Proto-Plastik/CLUB/README.md

# Printers-CLUB
Repository for the Proto-Plastik CLUB printer model
