Proto-Plastik/CLUB/A5 Bearing Assy Y-Axis/STEP/bearing cover and tray.STEP

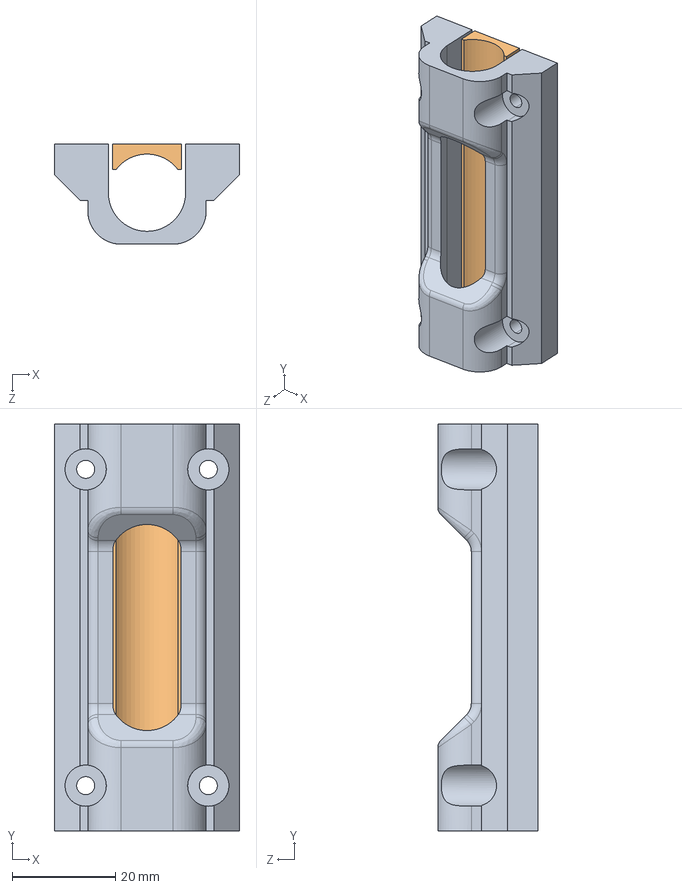
[picture p1: CAD file, 2019-01-01]
A5 Bearing Assy Y-Axis/STEP/bearing cover and tray.STEP
36.0 x 79.0 x 19.5 mm
