Proto-Plastik/CLUB/A5 Bed Chassis/STEP/bed chassis-belt retainer.STEP

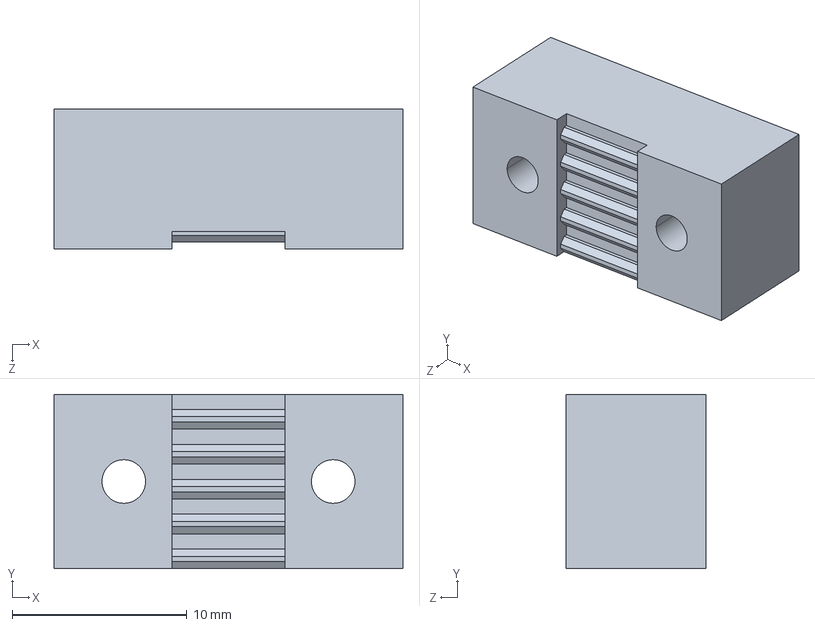
[picture p3: CAD file, 2019-01-01]
A5 Bed Chassis/STEP/bed chassis-belt retainer.STEP
20.0 x 10.0 x 8.00 mm
