Proto-Plastik/CLUB/A5 Frame Drive Housing 1Z Y-Axis/STEP/1Z y-axis-drive housing-cover.STEP

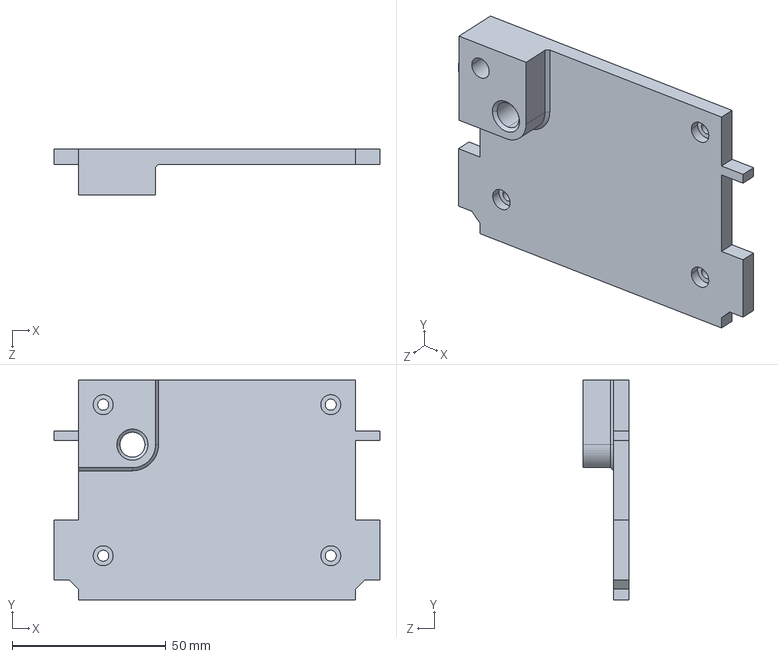
[picture p6: CAD file, 2019-01-01]
A5 Frame Drive Housing 1Z Y-Axis/STEP/1Z y-axis-drive housing-cover.STEP
106.0 x 71.5 x 15.0 mm
