Proto-Plastik/CLUB/A5 Frame Drive Housing 1Z Z-Axis/STEP/1Z z-axis-drive housing-cover.STEP

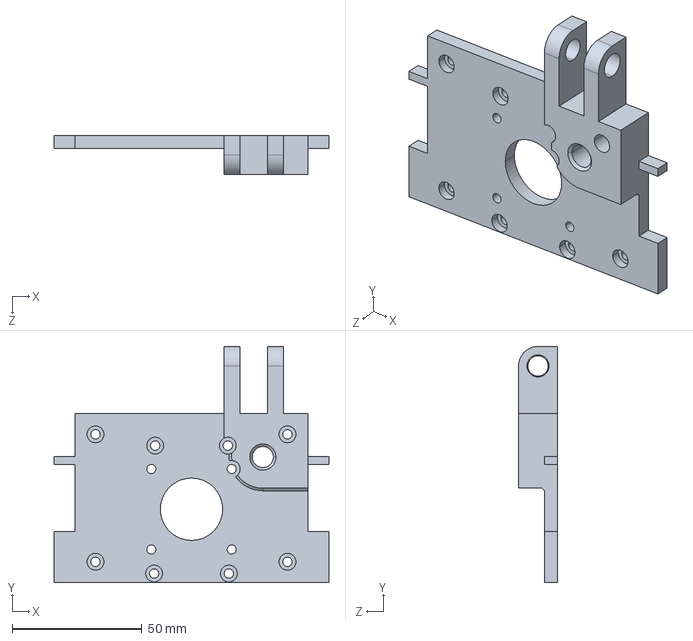
[picture p7: CAD file, 2019-01-01]
A5 Frame Drive Housing 1Z Z-Axis/STEP/1Z z-axis-drive housing-cover.STEP
106.0 x 91.0 x 15.0 mm
