Proto-Plastik/CLUB/A51Z Truss/STEP/truss handle bottom (ULTIMATE).STEP

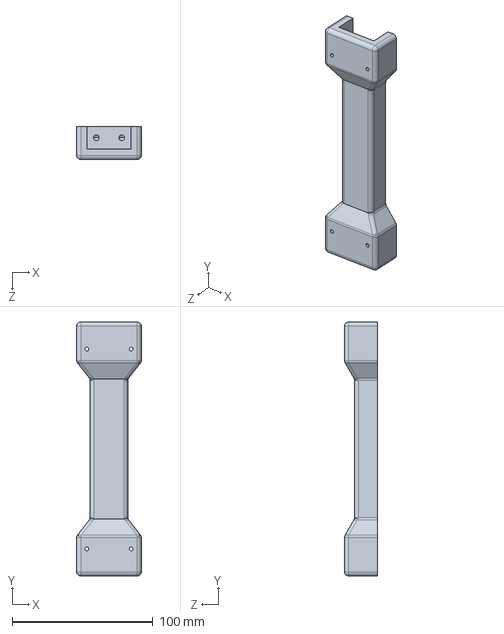
[picture p8: CAD file, 2019-01-01]
A51Z Truss/STEP/truss handle bottom (ULTIMATE).STEP
46.0 x 180.5 x 23.5 mm
