Proto-Plastik/CLUB/A51Z X-Axis Gantry-left/STEP/A51Z X-Gantry Left (300mm).STEP

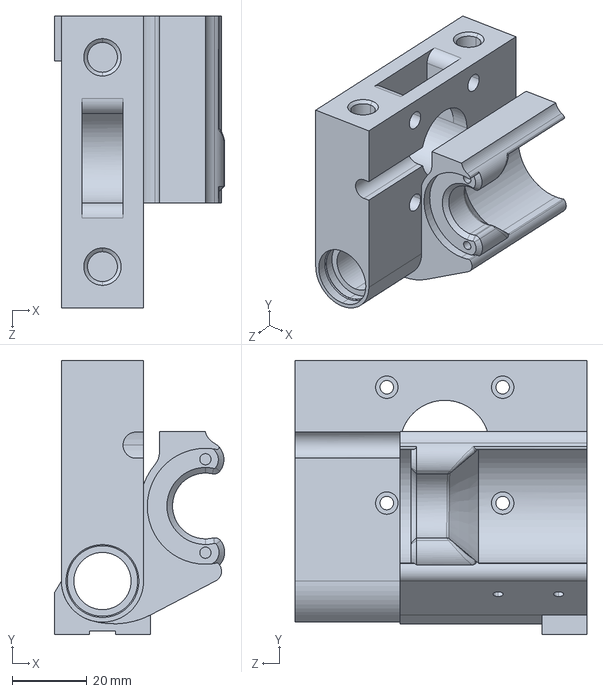
[picture p9: CAD file, 2019-01-01]
A51Z X-Axis Gantry-left/STEP/A51Z X-Gantry Left (300mm).STEP
45.6 x 73.3 x 78.0 mm
