Proto-Plastik/CLUB/A51Z X-Axis Gantry-right/STEP/A51Z X-Gantry Right (300mm).STEP

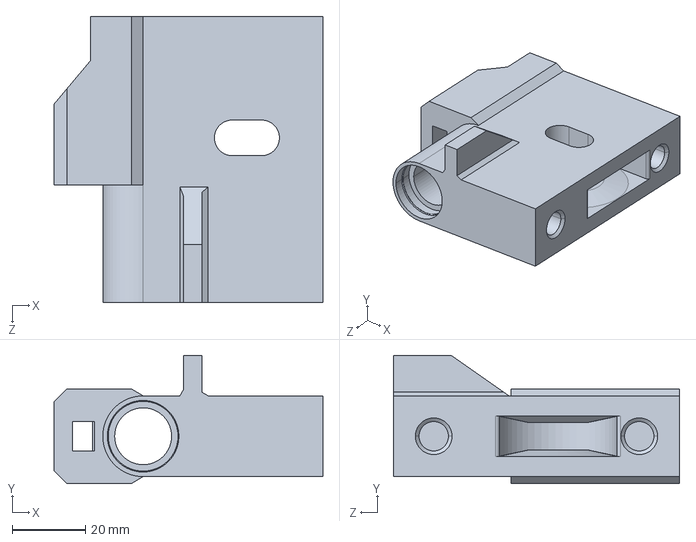
[picture p10: CAD file, 2019-01-01]
A51Z X-Axis Gantry-right/STEP/A51Z X-Gantry Right (300mm).STEP
73.3 x 34.9 x 78.0 mm
