Proto-Plastik/CLUB/Filament Drive Bearing Holder/STEP/bearing upper retainer (CLUB).STEP

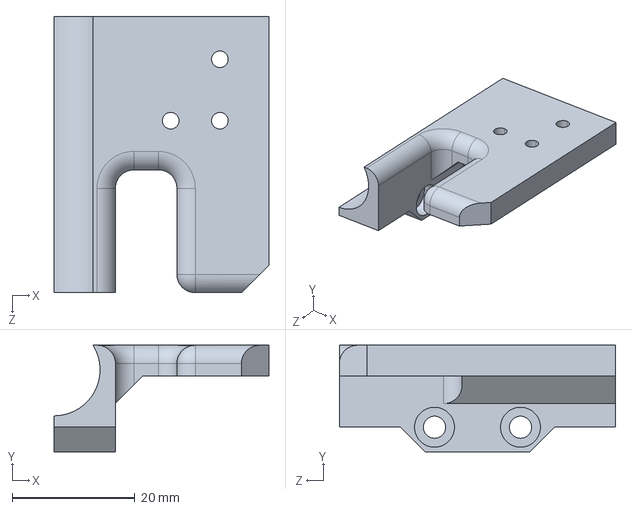
[picture p11: CAD file, 2019-01-01]
Filament Drive Bearing Holder/STEP/bearing upper retainer (CLUB).STEP
35.0 x 17.4 x 45.0 mm
