Proto-Plastik/CLUB/Filament Drive Bed Leveling/STEP/Filament Drive BL Touch Mount.STEP

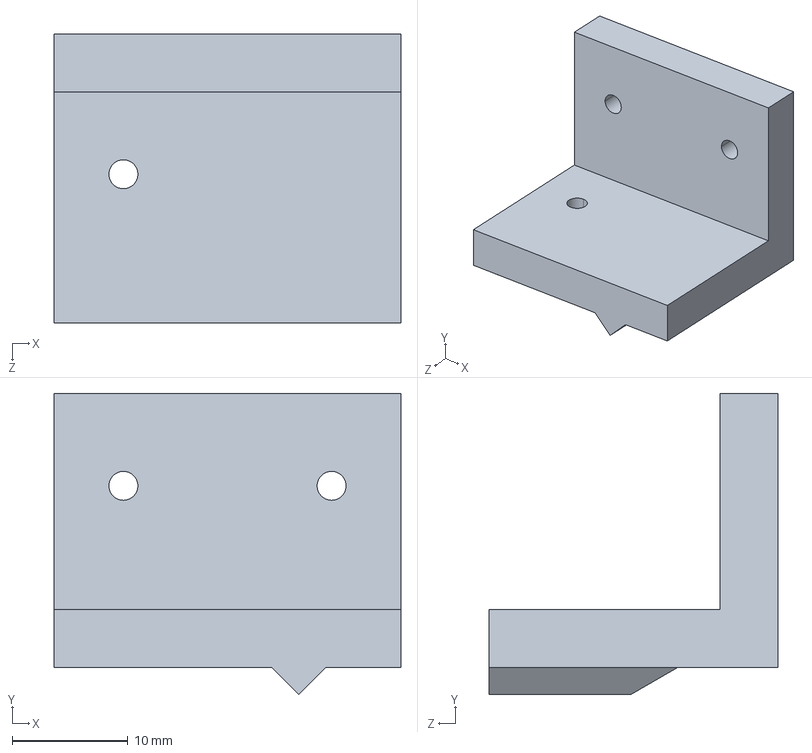
[picture p12: CAD file, 2018-01-10]
Filament Drive Bed Leveling/STEP/Filament Drive BL Touch Mount.STEP
30.0 x 26.1 x 25.0 mm
