Proto-Plastik/CLUB/Filament Drive Cooling Fan/STEP/fan nozzle.STEP

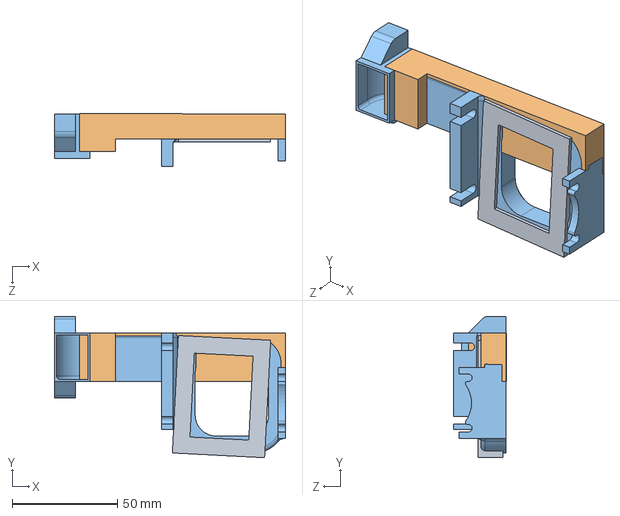
[picture p13: CAD file, 2018-01-10]
Filament Drive Cooling Fan/STEP/fan nozzle.STEP
110.0 x 67.3 x 25.1 mm
