Proto-Plastik/CLUB/Filament Drive Housing/hot end retainer.STL

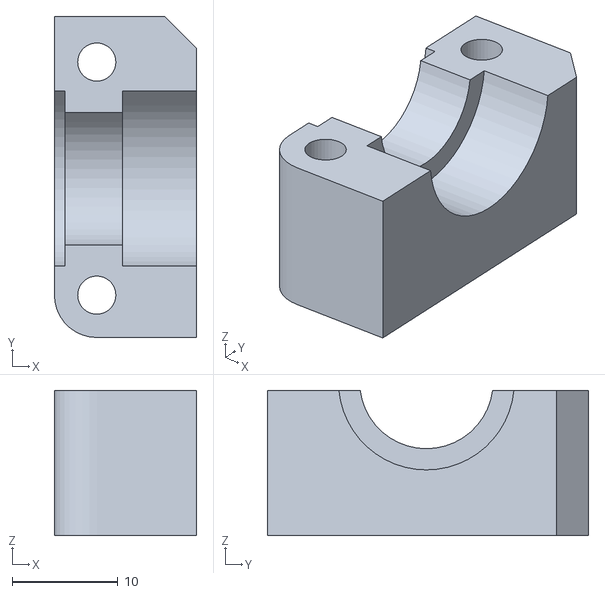
[picture p14: CAD file, 2018-01-06]
Filament Drive Housing/hot end retainer.STL
13.4 x 30.3 x 13.7
