Proto-Plastik/CLUB/Filament Drive/STEP/stepper (hardware)-dampener.STEP

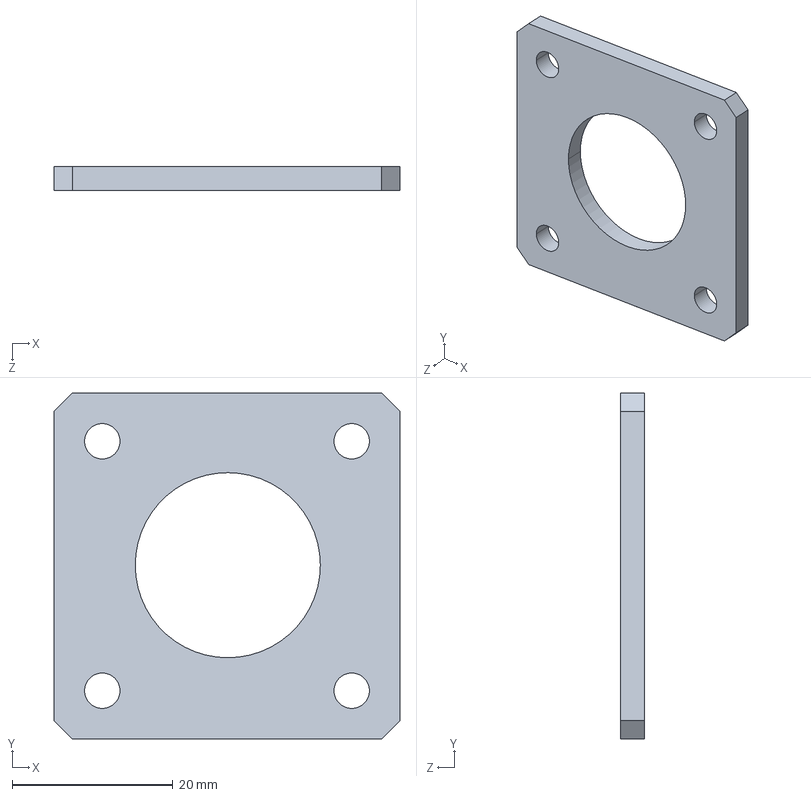
[picture p16: CAD file, 2019-01-01]
Filament Drive/STEP/stepper (hardware)-dampener.STEP
43.0 x 43.0 x 3.00 mm
