Proto-Plastik/CLUB/y-axis tightener/STEP/y-axis tightener-knob.STEP

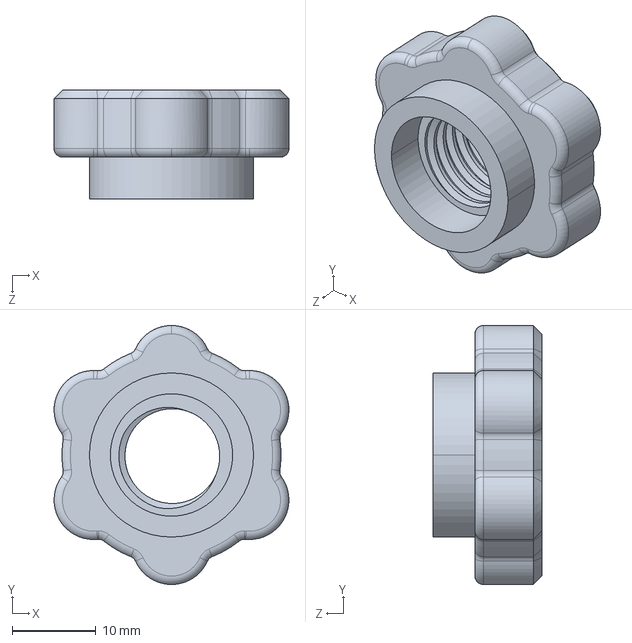
[picture p17: CAD file, 2019-01-01]
y-axis tightener/STEP/y-axis tightener-knob.STEP
28.1 x 31.0 x 13.0 mm
