Proto-Plastik/CLUB/y-axis tightener/y-axis tightener-upper clamp.STL

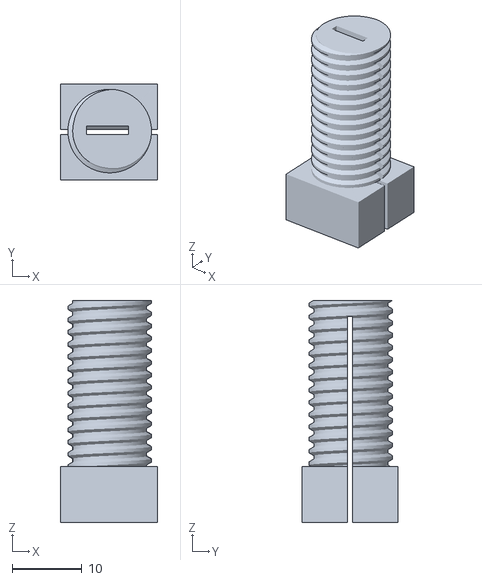
[picture p18: CAD file, 2019-01-01]
y-axis tightener/y-axis tightener-upper clamp.STL
13.9 x 13.7 x 31.8
