Proto-Plastik/CLUB/A5 Frame Chassis Center/STEP/chassis (300mm).STEP

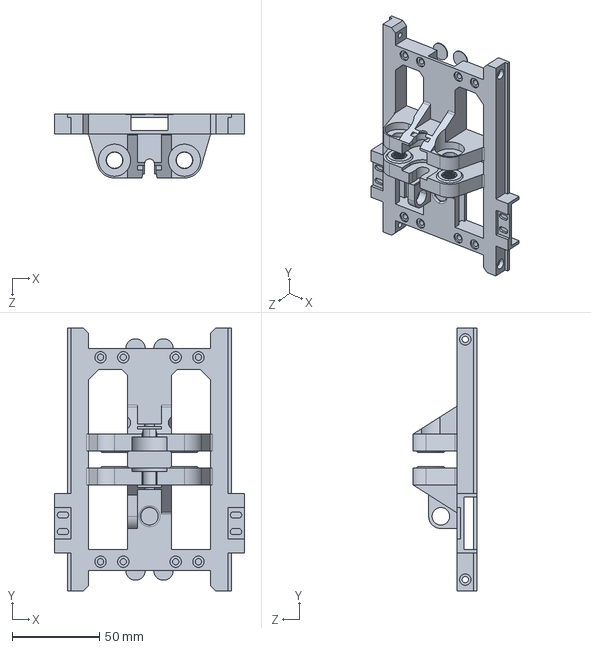
[picture p21: CAD file, 2019-01-01]
A5 Frame Chassis Center/STEP/chassis (300mm).STEP
109.0 x 150.5 x 36.7 mm
