Proto-Plastik/CLUB/A5 Frame Drive Housing 1Z Y-Axis/STEP/mounting foot TPE.STEP

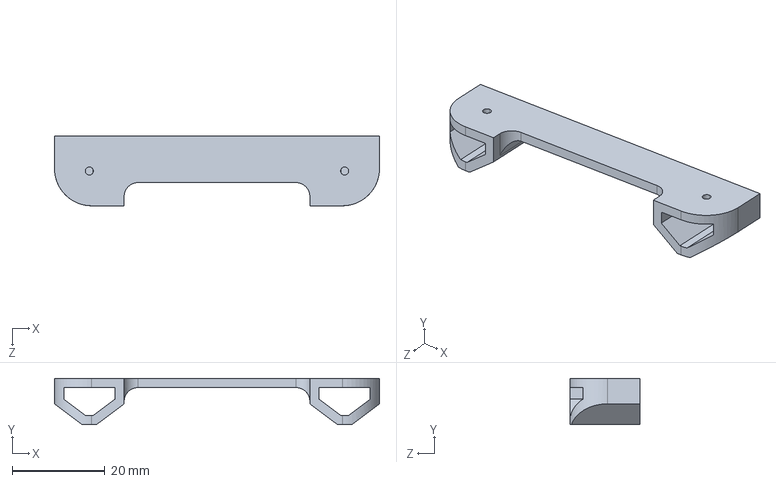
[picture p22: CAD file, 2019-01-01]
A5 Frame Drive Housing 1Z Y-Axis/STEP/mounting foot TPE.STEP
70.0 x 10.0 x 15.0 mm
