Proto-Plastik/CLUB/A5 Frame Drive Housing 1Z Z-Axis/STEP/rigid coupler.STEP

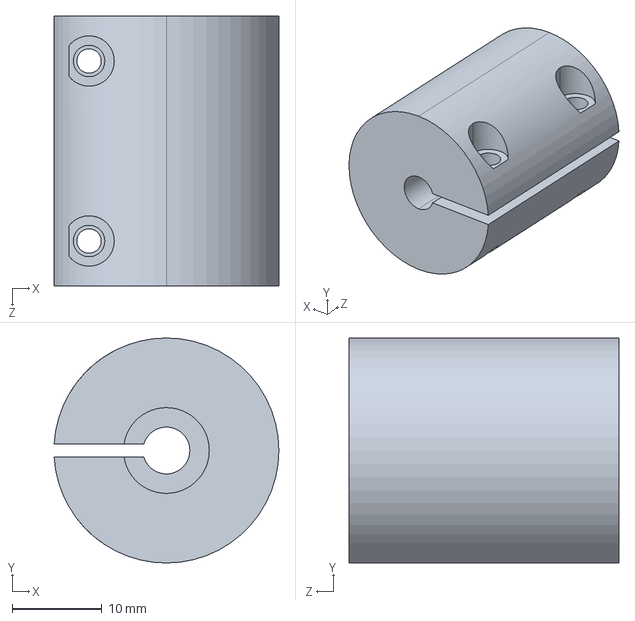
[picture p23: CAD file, 2019-01-01]
A5 Frame Drive Housing 1Z Z-Axis/STEP/rigid coupler.STEP
25.0 x 25.0 x 30.0 mm
