Proto-Plastik/CLUB/A51Z Truss/STEP/GT2_Pulley (printed pulley).STEP

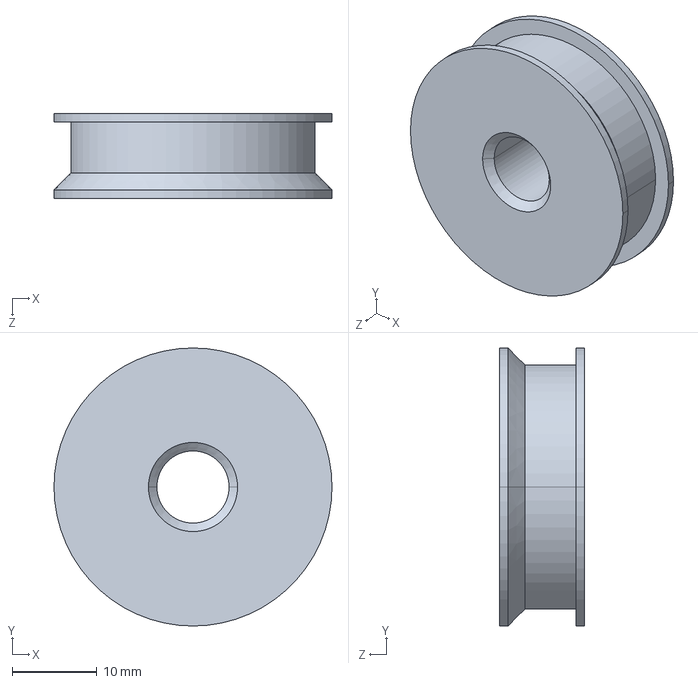
[picture p24: CAD file, 2019-01-01]
A51Z Truss/STEP/GT2_Pulley (printed pulley).STEP
32.7 x 32.7 x 10.0 mm
