Proto-Plastik/CLUB/A51Z X-Axis Gantry-left/STEP/A51Z X-Gantry-snap plug.STEP

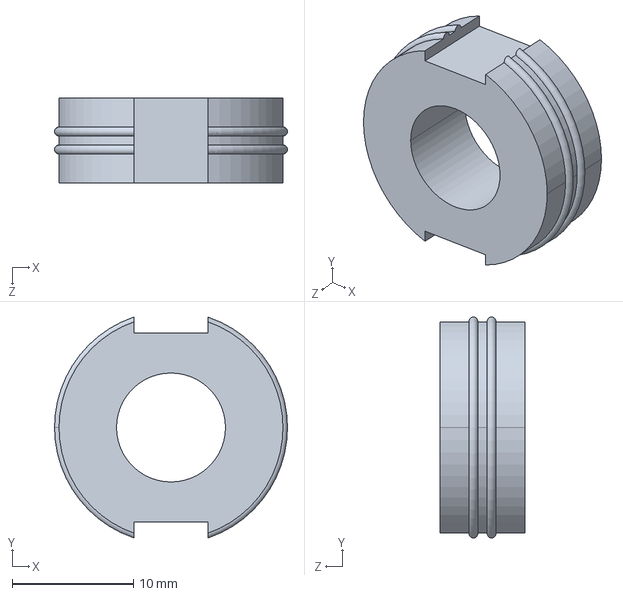
[picture p25: CAD file, 2019-01-01]
A51Z X-Axis Gantry-left/STEP/A51Z X-Gantry-snap plug.STEP
19.2 x 18.3 x 7.00 mm
