Proto-Plastik/CLUB/A51Z X-Axis Gantry-right/STEP/A51Z X-Gantry Right-tensioner.STEP

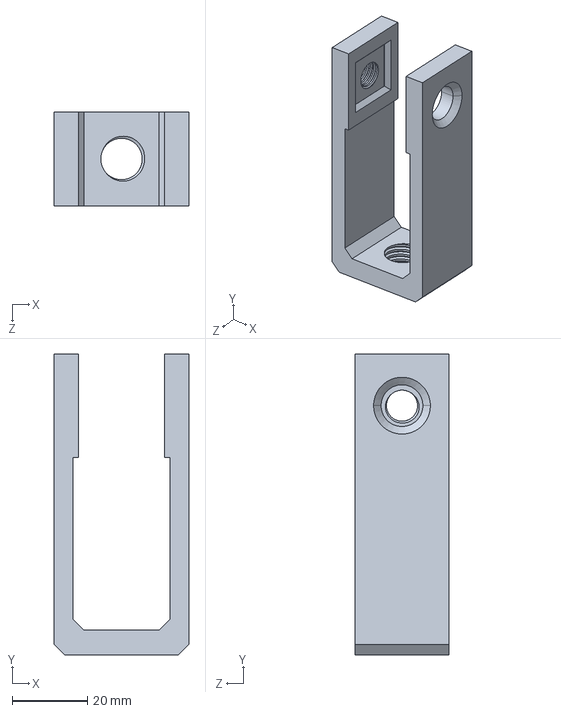
[picture p26: CAD file, 2019-01-01]
A51Z X-Axis Gantry-right/STEP/A51Z X-Gantry Right-tensioner.STEP
35.8 x 80.0 x 25.0 mm
