Proto-Plastik/CLUB/Filament Drive Bearing Holder/STEP/bearing lower retainer (CLUB).STEP

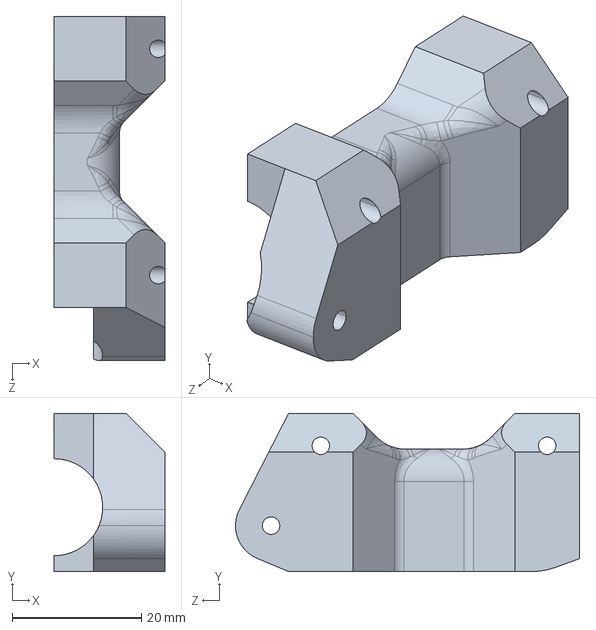
[picture p27: CAD file, 2019-01-01]
Filament Drive Bearing Holder/STEP/bearing lower retainer (CLUB).STEP
17.1 x 24.4 x 53.2 mm
