Proto-Plastik/CLUB/Filament Drive Cooling Fan/STEP/nozzle bracket.STEP

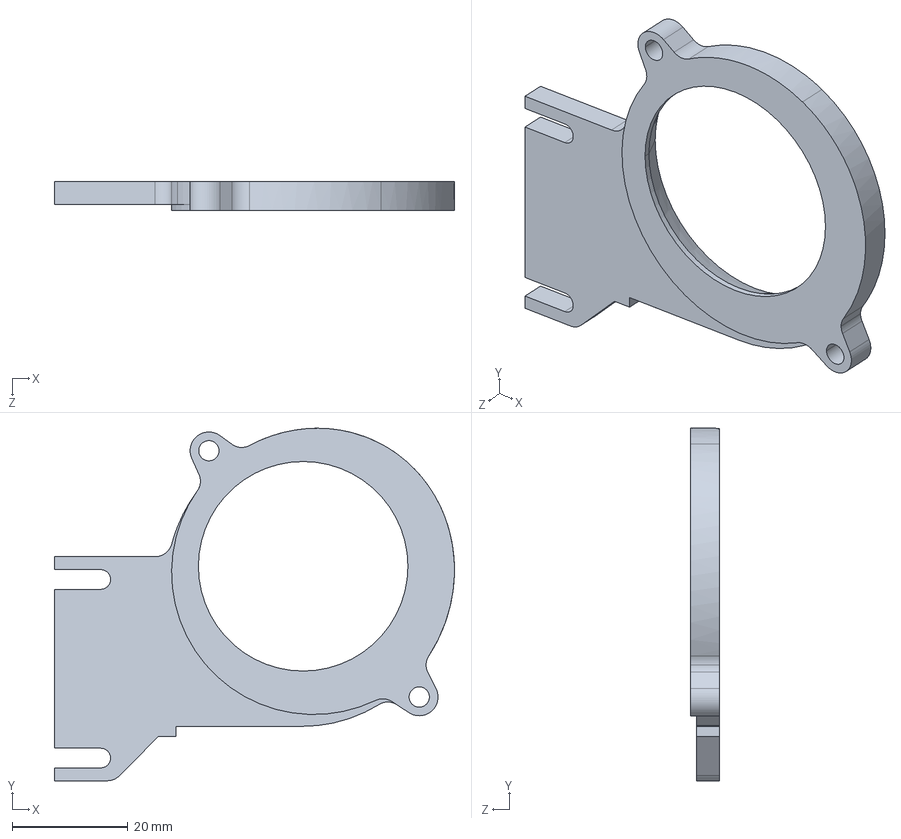
[picture p28: CAD file, 2018-01-10]
Filament Drive Cooling Fan/STEP/nozzle bracket.STEP
69.2 x 61.0 x 5.00 mm
