Proto-Plastik/CLUB/Filament Drive Housing/motor mount.STL

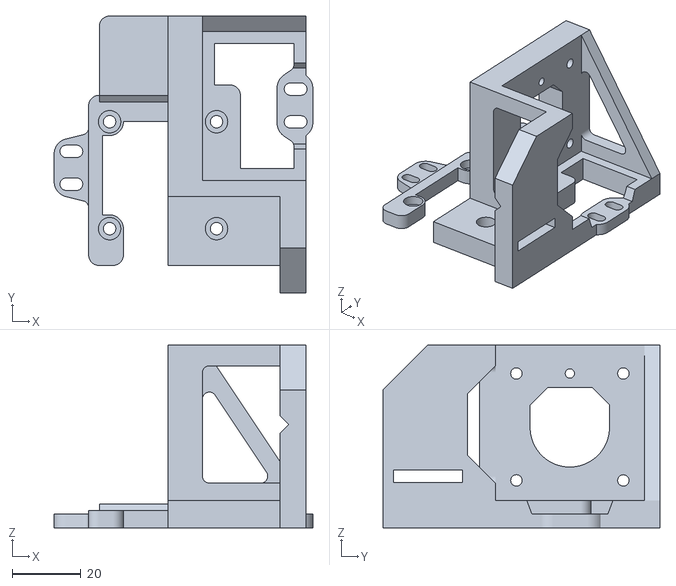
[picture p29: CAD file, 2017-12-31]
Filament Drive Housing/motor mount.STL
75.0 x 80.3 x 53.0
