Proto-Plastik/CLUB/A5 Bed Chassis/STEP/bed chassis-spreader-OH.STEP

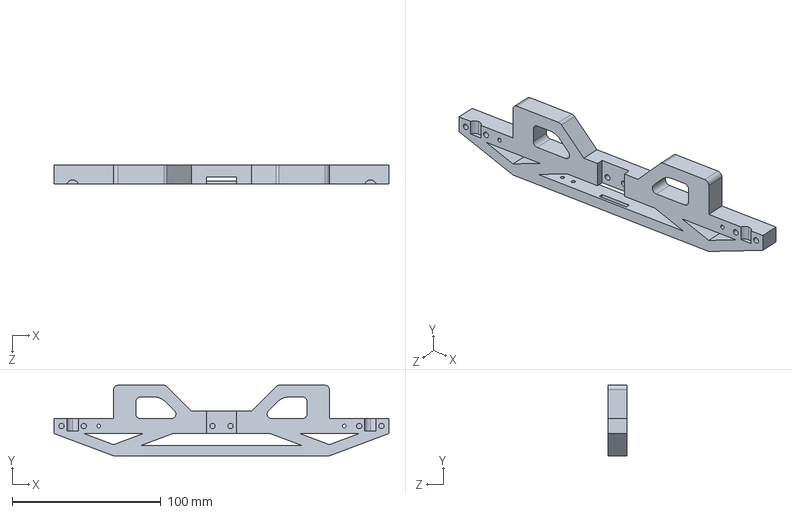
[picture p31: CAD file, 2019-01-01]
A5 Bed Chassis/STEP/bed chassis-spreader-OH.STEP
225.0 x 47.4 x 12.5 mm
