Proto-Plastik/CLUB/A5 Frame Drive Housing 1Z Y-Axis/STEP/1Z y-axis-drive housing-body.STEP

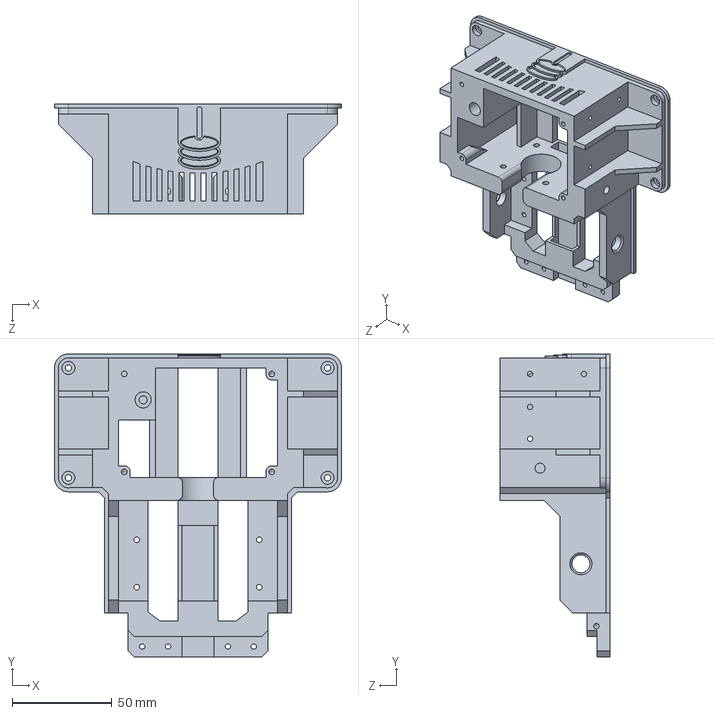
[picture p32: CAD file, 2019-01-01]
A5 Frame Drive Housing 1Z Y-Axis/STEP/1Z y-axis-drive housing-body.STEP
144.0 x 152.0 x 55.0 mm
