Proto-Plastik/CLUB/A5 Frame Drive Housing 1Z Z-Axis/STEP/RAMPS Mount-front.STEP

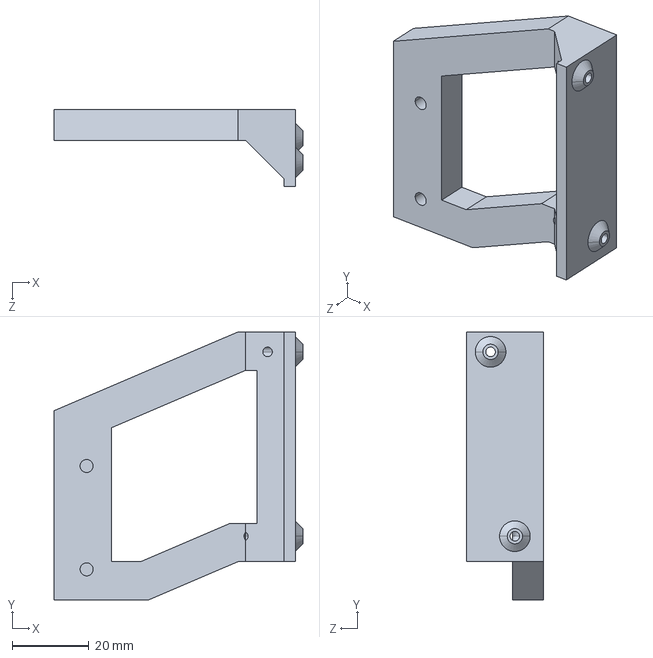
[picture p33: CAD file, 2019-01-01]
A5 Frame Drive Housing 1Z Z-Axis/STEP/RAMPS Mount-front.STEP
65.0 x 70.0 x 20.0 mm
