Proto-Plastik/CLUB/A51Z Truss/STEP/truss right .STEP

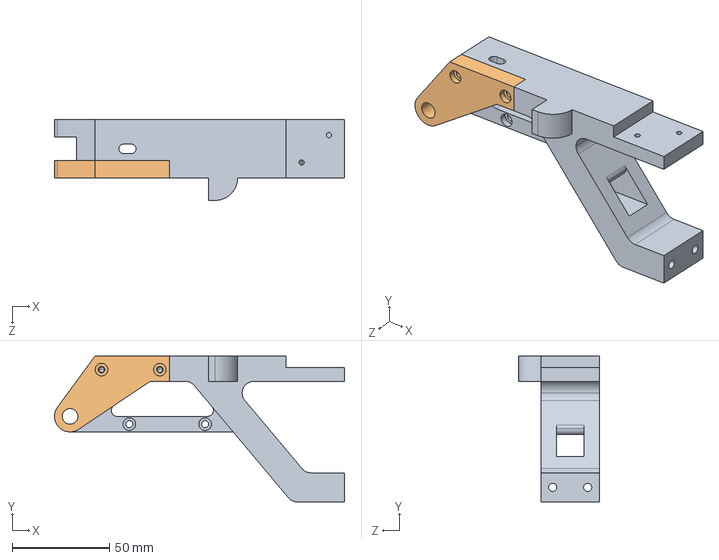
[picture p34: CAD file, 2019-01-01]
A51Z Truss/STEP/truss right .STEP
149.0 x 75.0 x 41.5 mm
