Proto-Plastik/CLUB/A51Z X-Axis Gantry-left/STEP/A51Z X-Gantry Left-retainer (grooved).STEP

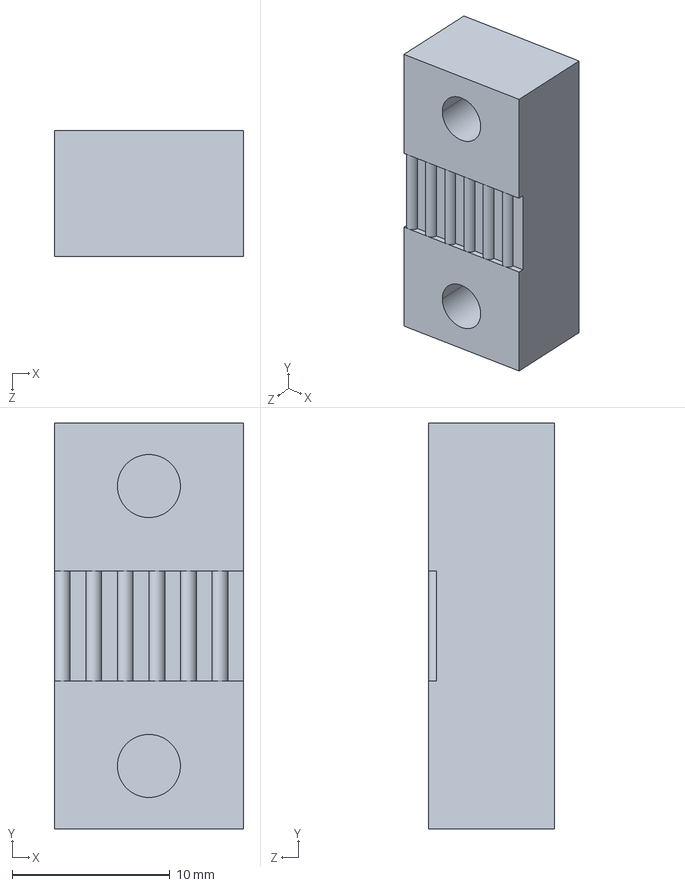
[picture p35: CAD file, 2019-01-01]
A51Z X-Axis Gantry-left/STEP/A51Z X-Gantry Left-retainer (grooved).STEP
12.0 x 25.8 x 8.00 mm
