Proto-Plastik/CLUB/Filament Drive Bearing Holder/STEP/bearing holder body (LM8LUU).STEP

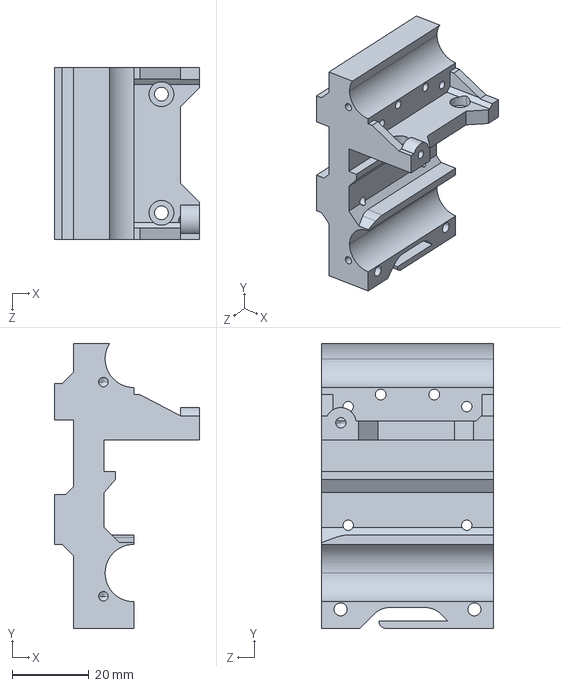
[picture p36: CAD file, 2019-01-01]
Filament Drive Bearing Holder/STEP/bearing holder body (LM8LUU).STEP
38.0 x 74.5 x 45.0 mm
