Proto-Plastik/CLUB/Filament Drive Housing/filament guide access.STL

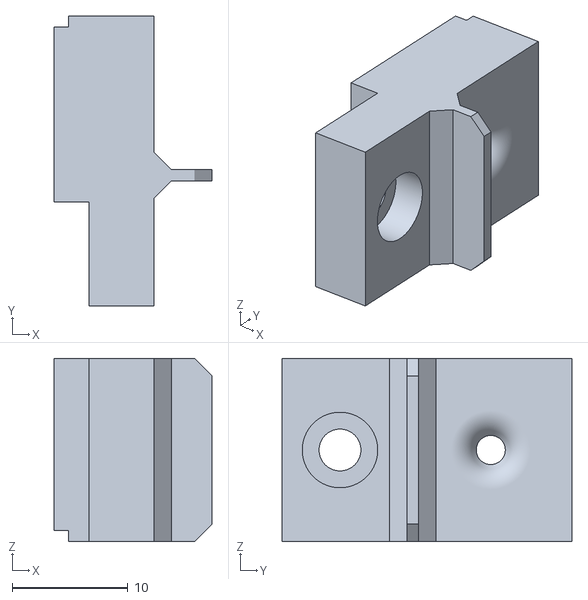
[picture p37: CAD file, 2017-12-31]
Filament Drive Housing/filament guide access.STL
13.6 x 25.0 x 15.8
