Proto-Plastik/CLUB/A5 Bed Build Platform/STEP/spring cup.STEP

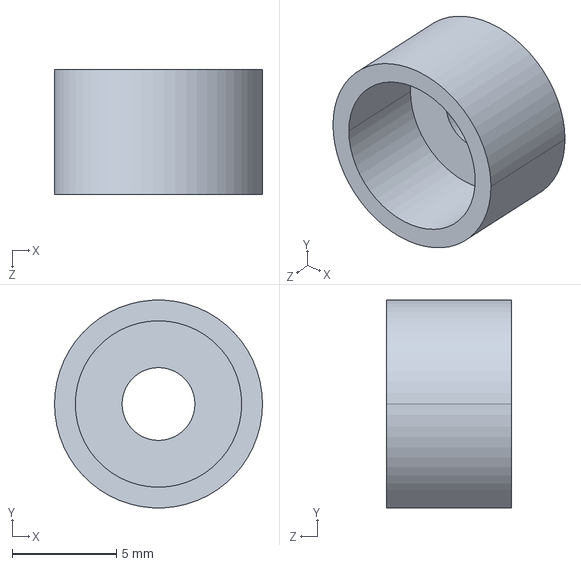
[picture p38: CAD file, 2019-01-01]
A5 Bed Build Platform/STEP/spring cup.STEP
10.0 x 9.99 x 6.00 mm
