Proto-Plastik/CLUB/A5 Frame Drive Housing 1Z Z-Axis/STEP/RAMPS Mount-rear.STEP

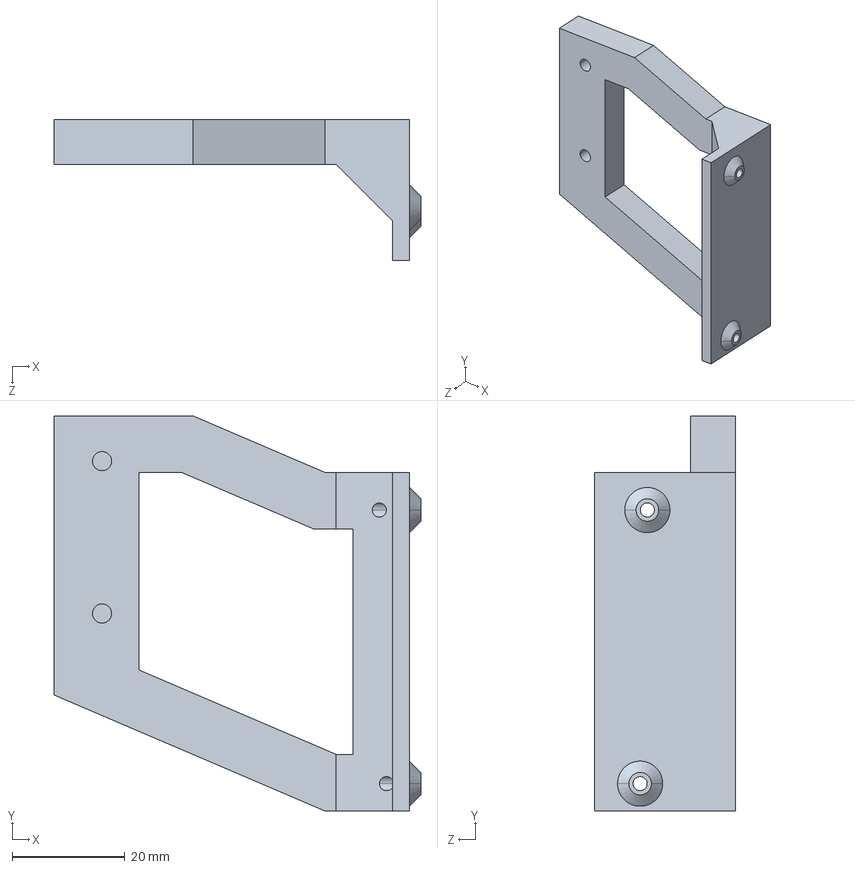
[picture p39: CAD file, 2019-01-01]
A5 Frame Drive Housing 1Z Z-Axis/STEP/RAMPS Mount-rear.STEP
65.0 x 70.0 x 25.0 mm
