Proto-Plastik/CLUB/A51Z Truss/STEP/truss handle top.STEP

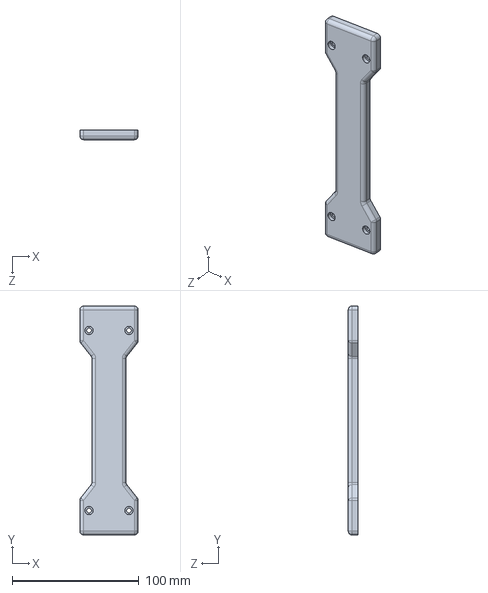
[picture p40: CAD file, 2019-01-01]
A51Z Truss/STEP/truss handle top.STEP
46.0 x 180.5 x 7.50 mm
