Proto-Plastik/CLUB/A51Z X-Axis Gantry-right/STEP/A51Z X-Gantry Right-tightening knob.STEP

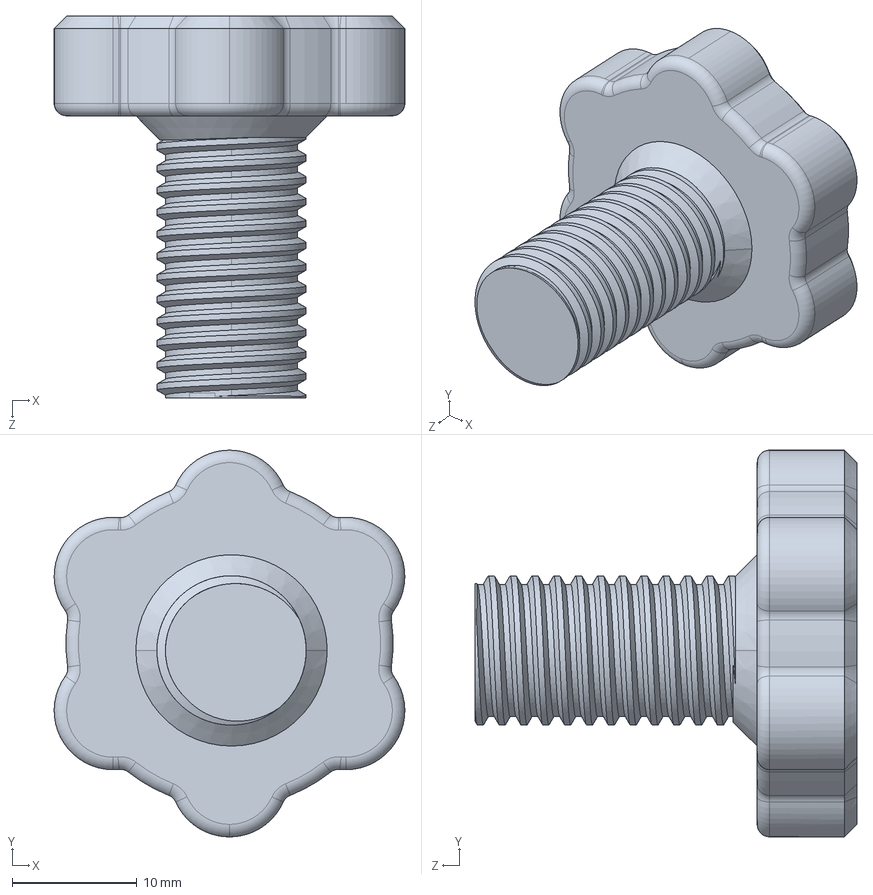
[picture p41: CAD file, 2019-01-01]
A51Z X-Axis Gantry-right/STEP/A51Z X-Gantry Right-tightening knob.STEP
28.1 x 31.0 x 30.6 mm
