Proto-Plastik/CLUB/Filament Drive Housing/hot end mount-body.STL

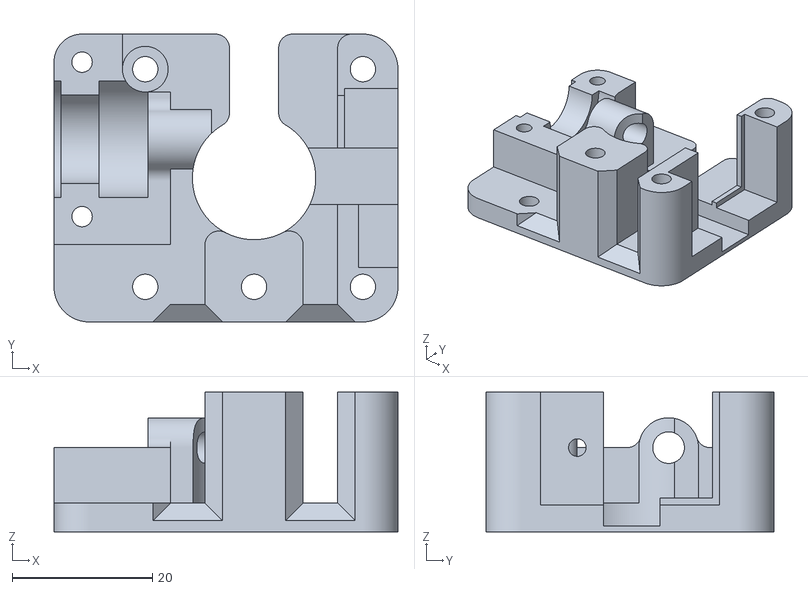
[picture p43: CAD file, 2017-12-31]
Filament Drive Housing/hot end mount-body.STL
49.0 x 41.0 x 19.9
