Proto-Plastik/CLUB/Filament Drive/STEP/hot end cover.STEP

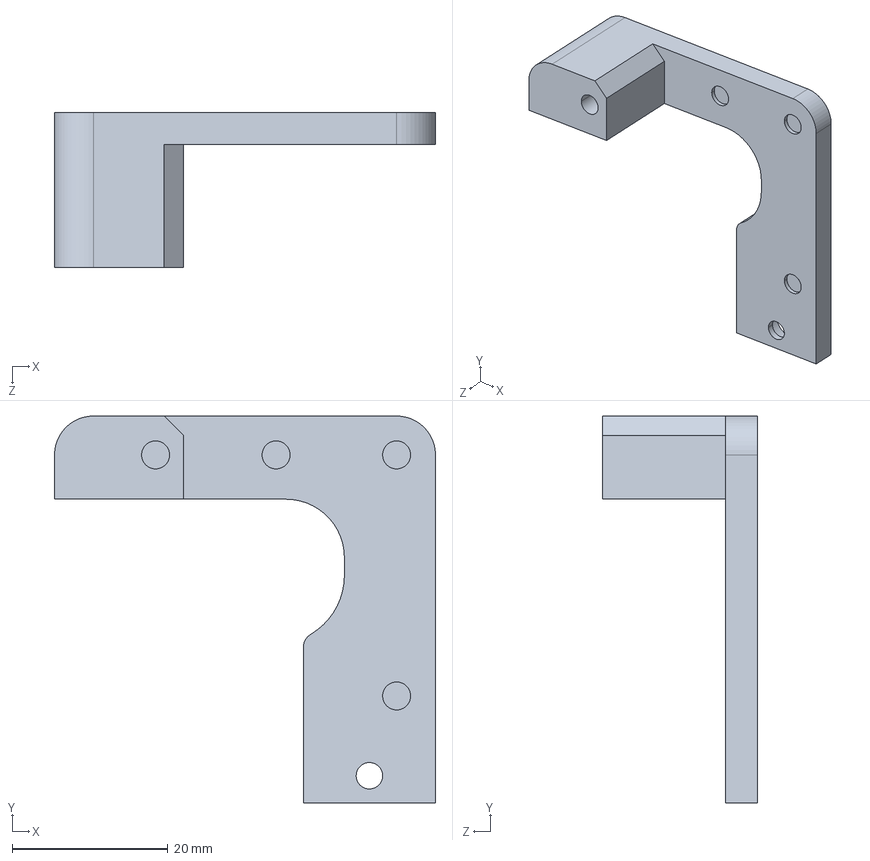
[picture p44: CAD file, 2019-01-01]
Filament Drive/STEP/hot end cover.STEP
49.0 x 49.8 x 19.9 mm
