Proto-Plastik/CLUB/A5 Bed Chassis/STEP/bed chassis-end stop.STEP

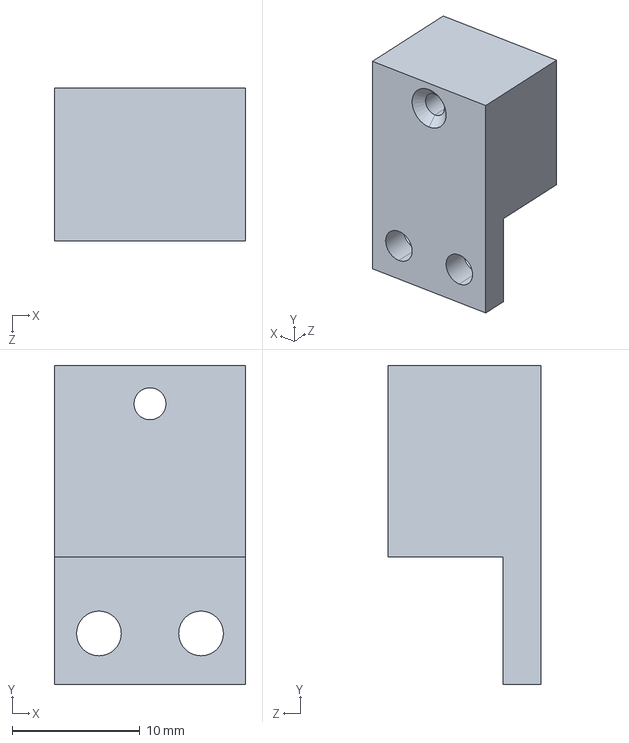
[picture p46: CAD file, 2018-01-10]
A5 Bed Chassis/STEP/bed chassis-end stop.STEP
15.0 x 25.0 x 12.0 mm
