Proto-Plastik/CLUB/A5 Frame Drive Housing 1Z Z-Axis/STEP/RAMPS1_4-cover.STEP

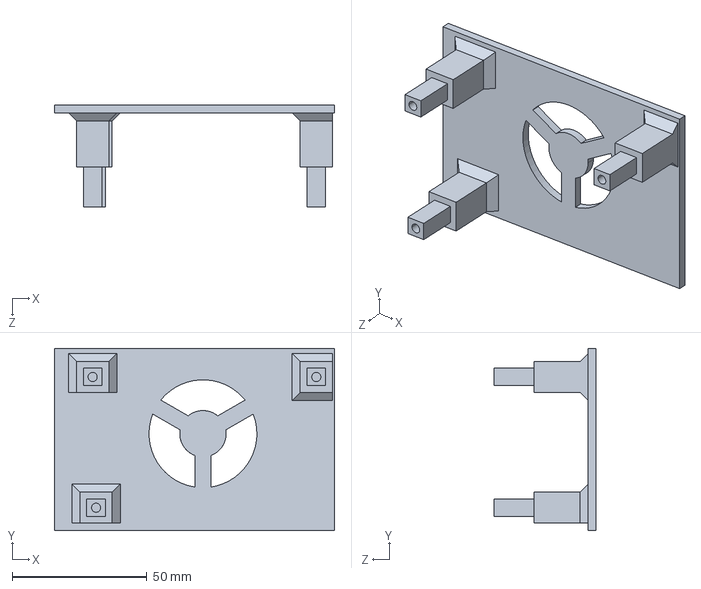
[picture p47: CAD file, 2019-01-01]
A5 Frame Drive Housing 1Z Z-Axis/STEP/RAMPS1_4-cover.STEP
103.9 x 67.7 x 38.0 mm
