Proto-Plastik/CLUB/A51Z Truss/STEP/truss left  (CLASSIC).STEP

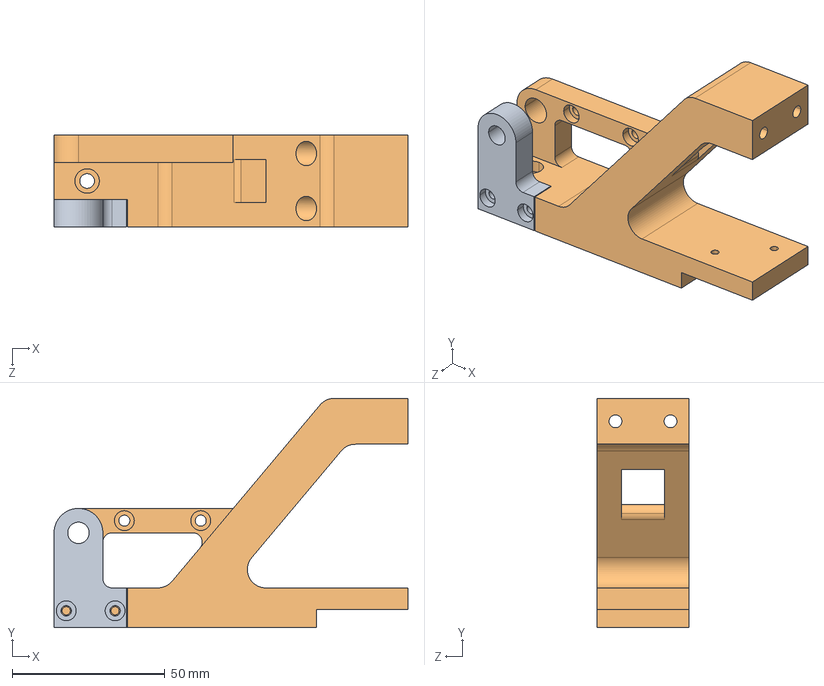
[picture p48: CAD file, 2019-01-01]
A51Z Truss/STEP/truss left (CLASSIC).STEP
115.8 x 75.0 x 30.0 mm
