Proto-Plastik/CLUB/A5 Bed Build Platform/STEP/glass support.STEP

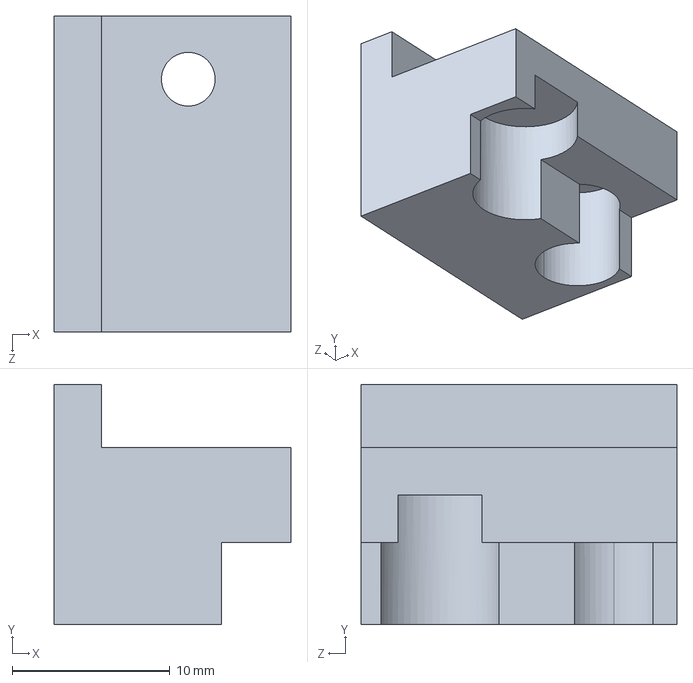
[picture p49: CAD file, 2018-02-09]
A5 Bed Build Platform/STEP/glass support.STEP
15.0 x 15.2 x 20.0 mm
