Proto-Plastik/CLUB/A51Z Truss/STEP/truss center (1Z).STEP

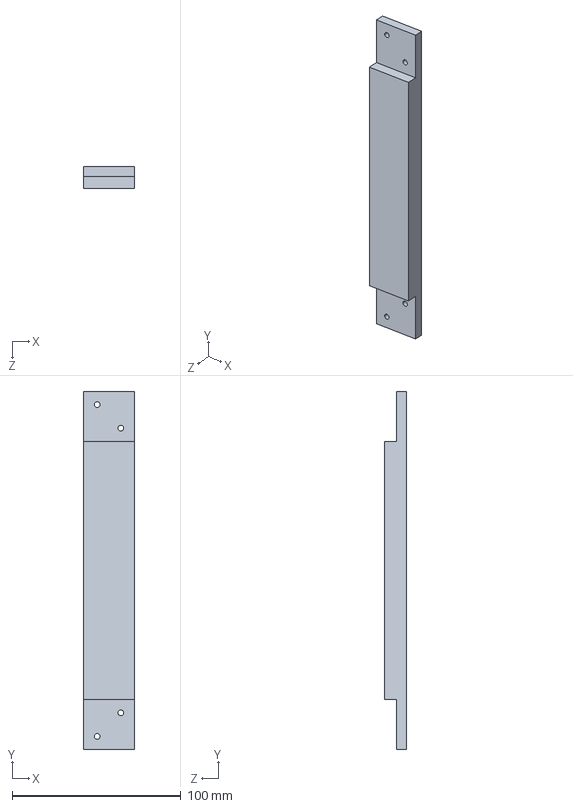
[picture p50: CAD file, 2019-01-01]
A51Z Truss/STEP/truss center (1Z).STEP
30.0 x 212.0 x 13.0 mm
