Proto-Plastik/CLUB/A51Z X-Axis Gantry-left/STEP/ACME threaded retainer.STEP

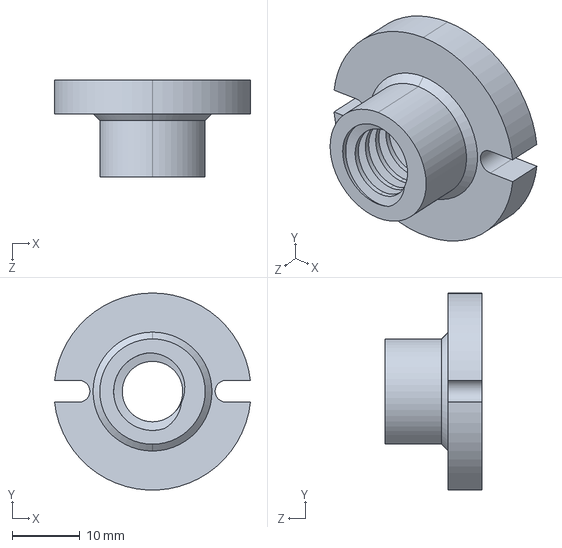
[picture p51: CAD file, 2018-01-10]
A51Z X-Axis Gantry-left/STEP/ACME threaded retainer.STEP
28.8 x 29.0 x 14.3 mm
