Proto-Plastik/CLUB/A51Z Truss/STEP/filament guide (single).STEP

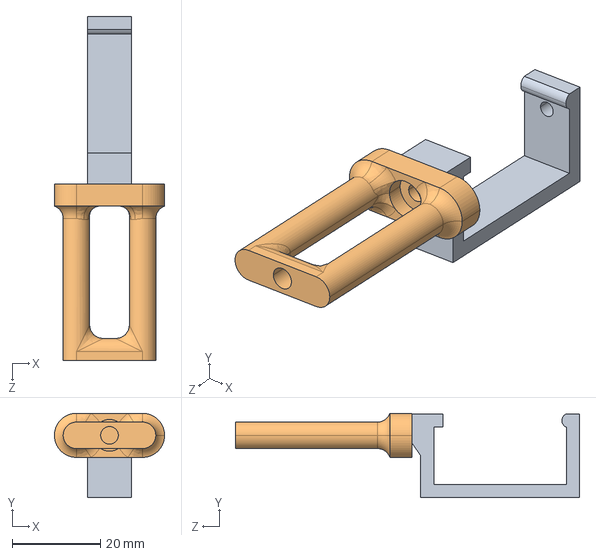
[picture p53: CAD file, 2019-01-01]
A51Z Truss/STEP/filament guide (single).STEP
25.0 x 19.1 x 78.0 mm
