Proto-Plastik/CLUB/A51Z X-Axis Gantry-right/STEP/A51Z X-Gantry Right-axle.STEP

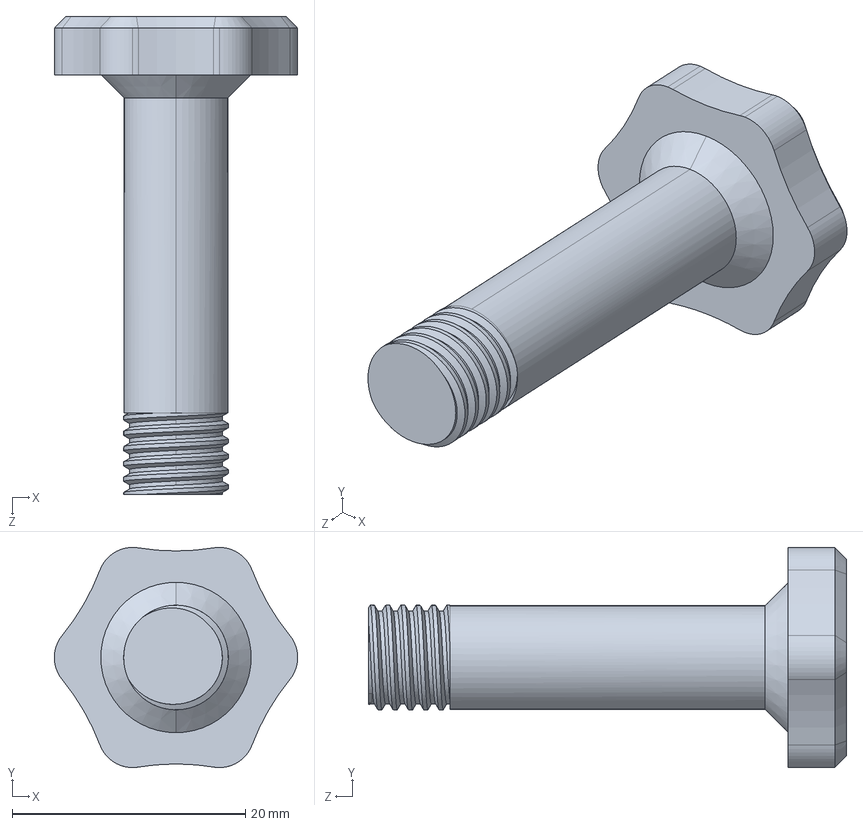
[picture p54: CAD file, 2019-01-01]
A51Z X-Axis Gantry-right/STEP/A51Z X-Gantry Right-axle.STEP
20.9 x 18.9 x 41.0 mm
