Proto-Plastik/CLUB/A5 Frame Drive Housing 1Z Z-Axis/STEP/1Z z-axis drive housing-body.STEP

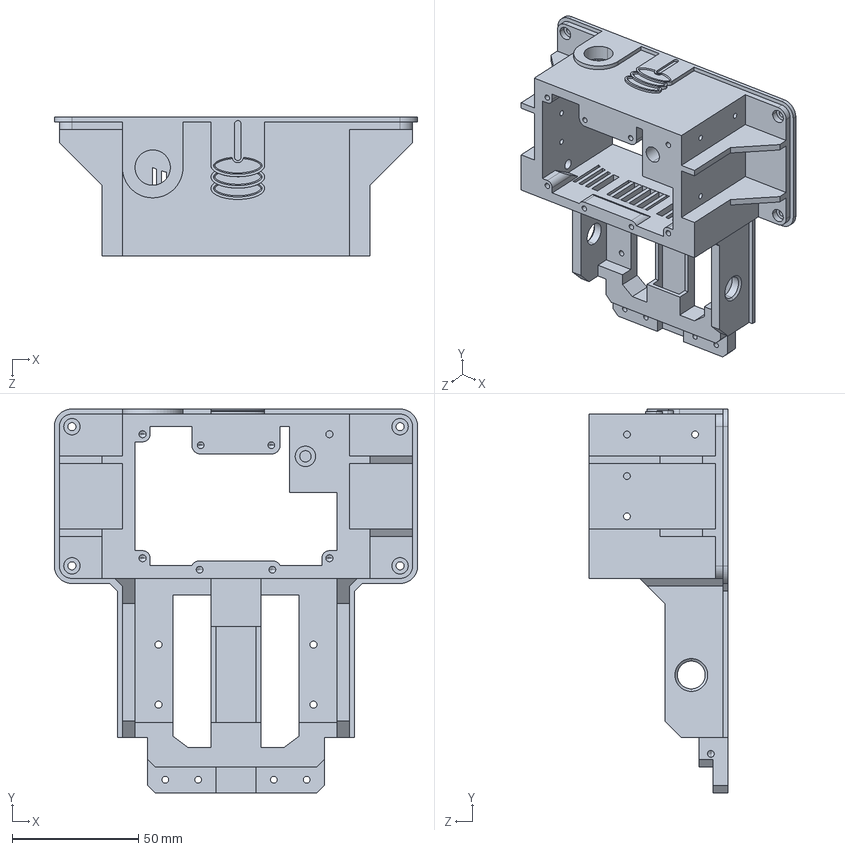
[picture p55: CAD file, 2019-01-01]
A5 Frame Drive Housing 1Z Z-Axis/STEP/1Z z-axis drive housing-body.STEP
144.0 x 152.1 x 55.0 mm
