Proto-Plastik/CLUB/A51Z Truss/STEP/truss right-retainer .STEP

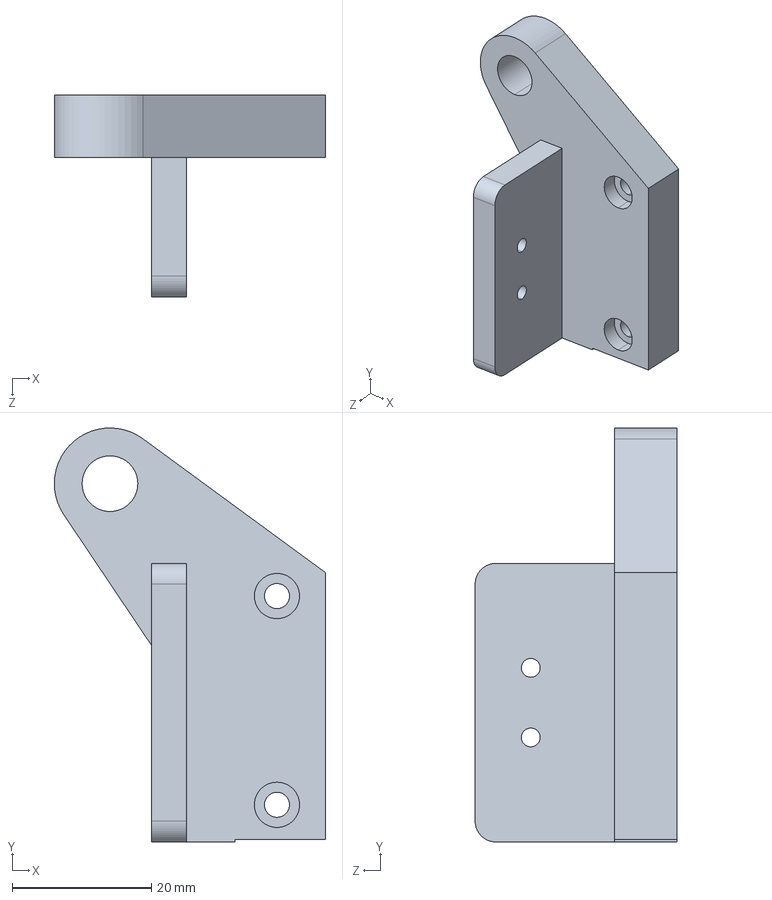
[picture p56: CAD file, 2019-01-01]
A51Z Truss/STEP/truss right-retainer .STEP
39.0 x 59.5 x 29.0 mm
