Proto-Plastik/CLUB/A51Z Truss/STEP/truss left-retainer .STEP

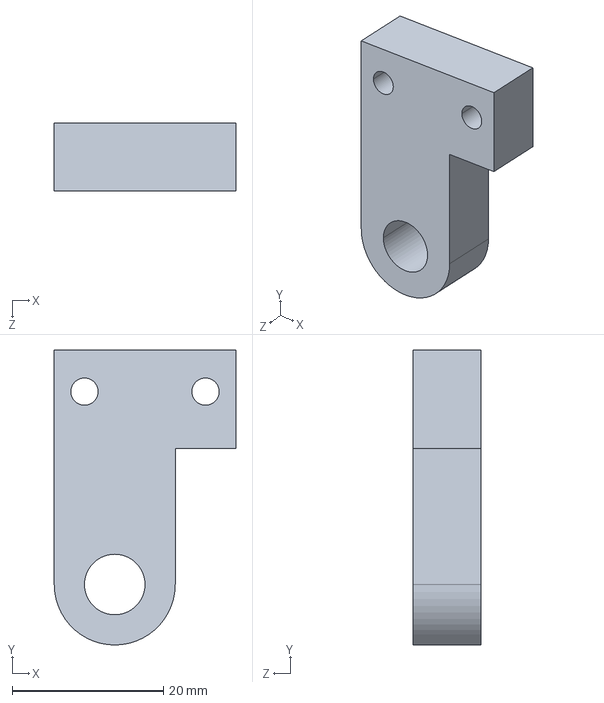
[picture p57: CAD file, 2019-01-01]
A51Z Truss/STEP/truss left-retainer .STEP
24.0 x 39.0 x 9.00 mm
