Proto-Plastik/CLUB/(list of files, cad)

Other CAD files:
A5 Bed/STEP/build platform-clip retainer.STEP
Filament Drive/STEP/hot end retainer.STEP
A5 Bed Build Platform/STEP/build platform-NE.STEP
A5 Frame Chassis Center/STEP/chassis.STEP
A51Z X-Axis Gantry-right/STEP/A51Z X-Gantry-snap plug.STEP
Filament Drive Tightener/STEP/tightening knob.STEP
Filament Drive/STEP/motor mount.STEP
A5 Bed Chassis/STEP/bed chassis-spreader.STEP
A51Z X-Axis Gantry-left/STEP/A51Z X-Gantry Left-retainer.STEP
A51Z X-Axis Gantry-left/STEP/A51Z X-Gantry Left.STEP
Filament Drive Bearing Holder/STEP/bearing lower retainer.STEP
Filament Drive Housing/hot end cover.STL
Filament Drive/STEP/filament guide access.STEP
A5 Frame Drive Housing 1Z Z-Axis/STEP/GT2_Pulley (printed pulley).STEP
A51Z X-Axis Gantry-right/STEP/A51Z X-Gantry Left-retainer.STEP
Filament Drive Bearing Holder/STEP/bearing upper retainer.STEP
A5 Bed Build Platform/STEP/glass support-OH.STEP
A5 Frame Drive Housing 1Z Z-Axis/STEP/mounting foot TPE.STEP
Filament Drive Bearing Holder/STEP/bearing holder body.STEP
A51Z X-Axis Gantry-right/STEP/A51Z X-Gantry Right.STEP
A5 Frame Drive Housing 1Z Z-Axis/STEP/GT2_Pulley.STEP
A51Z Truss/STEP/truss left .STEP
A51Z Truss/STEP/truss center.STEP
A51Z Truss/STEP/GT2_Pulley.STEP
A51Z Truss/STEP/truss handle bottom.STEP
A51Z Truss/STEP/filament guide.STEP
A5 Bearing Assy Y-Axis/bearing cover and tray.STL
A5 Bed Build Platform/build platform-NE.STL
A5 Bed Build Platform/build platform-NW.STL
A5 Bed Build Platform/build platform-SE.STL
A5 Bed Build Platform/build platform-SW.STL
A5 Bed Build Platform/glass support-OH.STL
A5 Bed Build Platform/glass support.STL
A5 Bed Build Platform/spring cup.STL
A5 Bed Chassis/bed chassis-belt retainer.STL
A5 Bed Chassis/bed chassis-end stop.STL
A5 Bed Chassis/bed chassis-shaft retainer.STL
A5 Bed Chassis/bed chassis-spreader-OH.STL
A5 Bed Chassis/bed chassis-spreader.STL
A5 Bed/build platform-clip retainer-OH.STL
A5 Bed/build platform-clip retainer.STL
A5 Frame Chassis Center/5mm ID x 8mm OD x 6mm Flanged.STL
A5 Frame Chassis Center/chassis (300mm).STL
A5 Frame Chassis Center/chassis.STL
A5 Frame Drive Housing 1Z Y-Axis/1Z y-axis-drive housing-body.STL
A5 Frame Drive Housing 1Z Y-Axis/1Z y-axis-drive housing-cover.STL
A5 Frame Drive Housing 1Z Y-Axis/mounting foot TPE.STL
A5 Frame Drive Housing 1Z Z-Axis/1Z z-axis drive housing-body.STL
A5 Frame Drive Housing 1Z Z-Axis/1Z z-axis-drive housing-cover.STL
A5 Frame Drive Housing 1Z Z-Axis/GT2_Pulley (printed pulley).STL
A5 Frame Drive Housing 1Z Z-Axis/GT2_Pulley.STL
A5 Frame Drive Housing 1Z Z-Axis/RAMPS Mount-front.STL
A5 Frame Drive Housing 1Z Z-Axis/RAMPS Mount-rear.STL
A5 Frame Drive Housing 1Z Z-Axis/RAMPS1_4-cover.STL
A5 Frame Drive Housing 1Z Z-Axis/mounting foot TPE.STL
A5 Frame Drive Housing 1Z Z-Axis/rigid coupler.STL
A51Z Truss/GT2_Pulley (printed pulley).STL
A51Z Truss/GT2_Pulley.STL
A51Z Truss/filament guide (single).STL
A51Z Truss/filament guide.STL
A51Z Truss/truss center (1Z).STL
A51Z Truss/truss center.STL
A51Z Truss/truss handle bottom (ULTIMATE).STL
A51Z Truss/truss handle bottom.STL
A51Z Truss/truss handle top.STL
A51Z Truss/truss left (CLASSIC).STL
A51Z Truss/truss left .STL
A51Z Truss/truss left-retainer .STL
A51Z Truss/truss right .STL
A51Z Truss/truss right-retainer .STL
A51Z X-Axis Gantry-left/A51Z X-Gantry Left (300mm).STL
A51Z X-Axis Gantry-left/A51Z X-Gantry Left-retainer (grooved).STL
A51Z X-Axis Gantry-left/A51Z X-Gantry Left-retainer.STL
A51Z X-Axis Gantry-left/A51Z X-Gantry Left.STL
A51Z X-Axis Gantry-left/A51Z X-Gantry-snap plug.STL
A51Z X-Axis Gantry-left/ACME threaded retainer.STL
A51Z X-Axis Gantry-right/A51Z X-Gantry Left-retainer.STL
A51Z X-Axis Gantry-right/A51Z X-Gantry Right (300mm).STL
A51Z X-Axis Gantry-right/A51Z X-Gantry Right-axle.STL
A51Z X-Axis Gantry-right/A51Z X-Gantry Right-lock nut.STL
A51Z X-Axis Gantry-right/A51Z X-Gantry Right-tensioner.STL
A51Z X-Axis Gantry-right/A51Z X-Gantry Right-tightening knob.STL
A51Z X-Axis Gantry-right/A51Z X-Gantry Right.STL
A51Z X-Axis Gantry-right/A51Z X-Gantry-snap plug.STL
A51Z X-Axis Gantry-right/STEP/A51Z X-Gantry Right-lock nut.STEP
Filament Drive Bearing Holder/bearing holder body (LM8LUU).STL
Filament Drive Bearing Holder/bearing holder body.STL
Filament Drive Bearing Holder/bearing lower retainer (CLUB).STL
Filament Drive Bearing Holder/bearing lower retainer.STL
Filament Drive Bearing Holder/bearing upper retainer (CLUB).STL
Filament Drive Bearing Holder/bearing upper retainer.STL
Filament Drive Bearing Holder/belt retainer.STL
Filament Drive Bed Leveling/Filament Drive BL Touch Mount.STL
Filament Drive Cooling Fan/fan nozzle.STL
Filament Drive Cooling Fan/nozzle bracket.STL
Filament Drive Tightener/STEP/lock nut.STEP
Filament Drive Tightener/lock nut.STL
Filament Drive Tightener/tensioner.STL
Filament Drive Tightener/tightening knob (filament drive).STL
Filament Drive Tightener/tightening knob.STL
Filament Drive/filament guide access.STL
Filament Drive/hot end cover.STL
Filament Drive/hot end mount-body.STL
Filament Drive/hot end retainer.STL
Filament Drive/motor mount.STL
Filament Drive/stepper (hardware)-dampener.STL
y-axis tightener/y-axis tightener-knob.STL
