Proto-Plastik/CLUB/(commit log)

2017-12-20 Initial upload.
    [1Z y-axis-drive housing-body.STL, 1Z y-axis-drive housing-cover.STL, 1Z z-axis drive housing-body.STL, 1Z z-axis-drive housing-cover.STL, 5mm ID x 8mm OD x 6mm Flanged.STL, A51Z X-Gantry Left-retainer.STL, A51Z X-Gantry Right-axle.STL, A51Z X-Gantry Right-tensioner.STL]
2017-12-20 Added Marlin firmware for use on the MKS Base 1.5 for the CLUB 3D Printer
    [Configuration.h, Configuration_adv.h]
2017-12-31 December EOM build
    [1Z y-axis-drive housing-body.STL, 1Z y-axis-drive housing-cover.STL, 1Z z-axis drive housing-body.STL, 1Z z-axis-drive housing-cover.STL, 5mm ID x 8mm OD x 6mm Flanged.STL, A51Z X-Gantry Left-retainer.STL, A51Z X-Gantry Right-axle.STL, A51Z X-Gantry Right-tensioner.STL]
2018-01-06 January first half commit
    [A51Z X-Gantry Left.STL, bearing upper retainer.STL, filament guide access.STL, hot end cover.STL, hot end mount-body.STL, hot end retainer.STL, motor mount.STL]
2018-01-07 Replaced ACIS (SAT) files with correct set of STEP files
    [1Z y-axis-drive housing-body.STEP, 1Z y-axis-drive housing-body.STL, 1Z y-axis-drive housing-cover.STEP, 1Z z-axis drive housing-body.STEP, 1Z z-axis drive housing-body.STL, 1Z z-axis-drive housing-cover.STEP, 5mm ID x 8mm OD x 6mm Flanged.STEP, 5mm ID x 8mm OD x 6mm Flanged.STL]
2018-01-10 Fixed a problem with part configuration
    [1Z y-axis-drive housing-body.STEP, 1Z y-axis-drive housing-cover.STEP, 1Z z-axis drive housing-body.STEP, 1Z z-axis-drive housing-cover.STEP, 5mm ID x 8mm OD x 6mm Flanged.STEP, A51Z X-Gantry Left-retainer.STEP, A51Z X-Gantry Left-retainer.STL, A51Z X-Gantry Left.STEP]
2018-02-09 Febuary Push. Modified bed to allow for better wire routing of the heated bed. Added Assembly documentation
    [1Z y-axis-drive housing-body.STEP, 1Z y-axis-drive housing-body.STL, 1Z y-axis-drive housing-cover.STEP, 1Z y-axis-drive housing-cover.STL, 1Z z-axis drive housing-body.STEP, 1Z z-axis drive housing-body.STL, 1Z z-axis-drive housing-cover.STEP, 1Z z-axis-drive housing-cover.STL]
2018-02-12 Minor update. Included some missing parts (lock nut for the x-axis gantry belt tightener).
    [1Z y-axis-drive housing-body.STEP, 1Z y-axis-drive housing-cover.STEP, 1Z z-axis drive housing-body.STEP, 1Z z-axis-drive housing-cover.STEP, 5mm ID x 8mm OD x 6mm Flanged.STEP, A51Z X-Gantry Left-retainer.STEP, A51Z X-Gantry Left.STEP, A51Z X-Gantry Right-axle.STEP]
2018-02-28 Monthly Build. Small modifications to the electronics base. No including the camera mount (For Ultimate)
    [1Z y-axis-drive housing-body.STEP, 1Z y-axis-drive housing-body.STL, 1Z y-axis-drive housing-cover.STEP, 1Z z-axis drive housing-body.STEP, 1Z z-axis drive housing-body.STL, 1Z z-axis-drive housing-cover.STEP, 5mm ID x 8mm OD x 6mm Flanged.STEP, A51Z X-Gantry Left-retainer.STEP]
2018-03-09 Updated the filament drive cover
    [1Z y-axis-drive housing-body.STEP, 1Z y-axis-drive housing-cover.STEP, 1Z z-axis drive housing-body.STEP, 1Z z-axis-drive housing-cover.STEP, 5mm ID x 8mm OD x 6mm Flanged.STEP, A51Z X-Gantry Left-retainer.STEP, A51Z X-Gantry Left.STEP, A51Z X-Gantry Right-axle.STEP]
2018-03-14 Mid March commit. Adjusted X-Axis gantry bearing retainers. Set the y-axis tightener for the front of the bed only.
    [1Z y-axis-drive housing-body.STEP, 1Z y-axis-drive housing-cover.STEP, 1Z z-axis drive housing-body.STEP, 1Z z-axis-drive housing-cover.STEP, 5mm ID x 8mm OD x 6mm Flanged.STEP, A51Z X-Gantry Left-retainer.STEP, A51Z X-Gantry Left.STEP, A51Z X-Gantry Right-axle.STEP]
2018-03-19 Remove extraneous Marlin folder
    [Configuration.h, Configuration_adv.h]
2018-03-19 Revert "Mid March commit. Adjusted X-Axis gantry bearing retainers. Set the y-axis tightener for the front of the bed only."
    This reverts commit 2b5d38c6eb9f78b0beb8d1bc64c2bd98d5275018.
    [1Z y-axis-drive housing-body.STEP, 1Z y-axis-drive housing-cover.STEP, 1Z z-axis drive housing-body.STEP, 1Z z-axis-drive housing-cover.STEP, 5mm ID x 8mm OD x 6mm Flanged.STEP, A51Z X-Gantry Left-retainer.STEP, A51Z X-Gantry Left.STEP, A51Z X-Gantry Right-axle.STEP]
2018-03-19 Revert "Revert "Mid March commit. Adjusted X-Axis gantry bearing retainers. Set the y-axis tightener for the front of the bed only.""
    This reverts commit b059884fe4ddc5c9b58f06030d319617b7513b49.
    [1Z y-axis-drive housing-body.STEP, 1Z y-axis-drive housing-cover.STEP, 1Z z-axis drive housing-body.STEP, 1Z z-axis-drive housing-cover.STEP, 5mm ID x 8mm OD x 6mm Flanged.STEP, A51Z X-Gantry Left-retainer.STEP, A51Z X-Gantry Left.STEP, A51Z X-Gantry Right-axle.STEP]
2018-03-19 Revert "Remove extraneous Marlin folder"
    This reverts commit e5e205a20a912987e8762300f5dff00c1e5f7aa3.
    [Configuration.h, Configuration_adv.h]
2018-03-20 Removed Firmware folders. Moved to Firmware repo.
    [Configuration.h, Configuration_adv.h]
2018-05-17 Mid-May update. Update to x-axis bearing carrier to accomodate belt and channel for wiring to be away from the belt.
    [1Z y-axis-drive housing-body.STEP, 1Z y-axis-drive housing-body.STL, 1Z y-axis-drive housing-cover.STEP, 1Z y-axis-drive housing-cover.STL, 1Z z-axis drive housing-body.STEP, 1Z z-axis drive housing-body.STL, 1Z z-axis-drive housing-cover.STEP, 1Z z-axis-drive housing-cover.STL]
2018-05-18 Corrected STL orientation
    [1Z y-axis-drive housing-body.STEP, 1Z y-axis-drive housing-body.STL, 1Z y-axis-drive housing-cover.STEP, 1Z y-axis-drive housing-cover.STL, 1Z z-axis drive housing-body.STEP, 1Z z-axis drive housing-body.STL, 1Z z-axis-drive housing-cover.STEP, 1Z z-axis-drive housing-cover.STL]
2019-01-01 New year build
    [1Z y-axis-drive housing-body.STEP, 1Z y-axis-drive housing-body.STL, 1Z y-axis-drive housing-cover.STEP, 1Z y-axis-drive housing-cover.STL, 1Z z-axis drive housing-body.STEP, 1Z z-axis drive housing-body.STL, 1Z z-axis-drive housing-cover.STEP, 1Z z-axis-drive housing-cover.STL]
2019-01-01 Updated naming convention to include configuration name shown in parentheses
    [1Z y-axis-drive housing-body.STEP, 1Z y-axis-drive housing-cover.STEP, 1Z z-axis drive housing-body.STEP, 1Z z-axis-drive housing-cover.STEP, 5mm ID x 8mm OD x 6mm Flanged.STEP, A51Z X-Gantry Left (300mm).STEP, A51Z X-Gantry Left (300mm).STL, A51Z X-Gantry Left-retainer (grooved).STEP]
